ajs123/KBikeBLE/docs/RJ9coiled.jpg

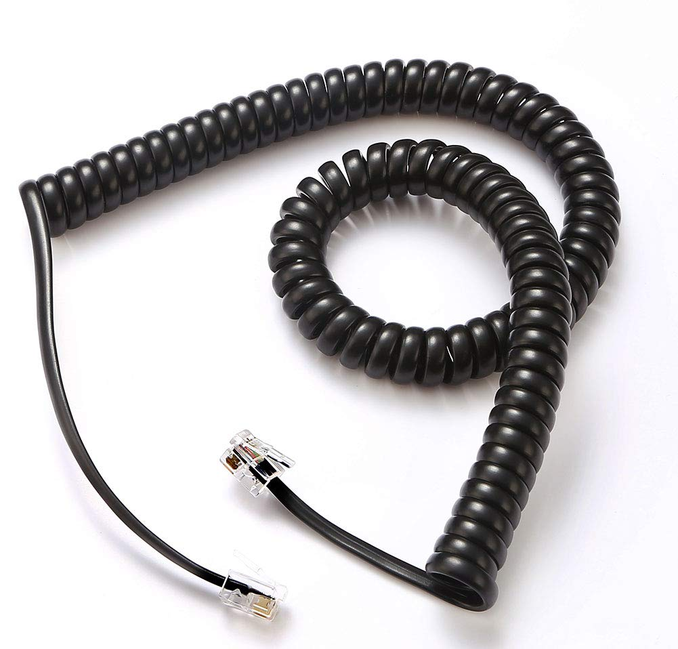
docs/RJ9coiled.jpg
