ajs123/KBikeBLE/(threads)

Thread 1 (2021-06-26):

Parts List

Longhorn17, 2021-06-26:
I'm a fellow M3 bike user and have been looking for this exact solution for my bike to be able to connect via bluetooth with fitness apps.

I'm new to coding and these kind of DIY projects in general and I thought this was a good real world project to dive into but I'm struggling a little to know which components are necessary and compatible for this project.

I was wondering if you could post a list of the exact Arduino board, display, and other parts for this project that you are using?

Sorry if this isn't the correct forum to ask this, I'm new to Github as well.

I think what you have done is pretty awesome and appreciate you sharing it.

nealjane, 2021-06-26:
Hi @Longhorn17 ,

depending where you are In The world- but an Easyer solution if you’re in Europe is the ‘Dpcycling’ m3 adapter- it’s ~£100 imported from Spain to Uk. (Have had one for 1.5years and makes your m3 work like M3i with Bluetooth)

www.siliconegrips.es

Longhorn17, 2021-06-26:
I've come across that before but unfortunately I live in the US.

I'll look into just upgrading the computer. Thanks for the suggestion!

nealjane, 2021-06-26:
https://m.facebook.com/groups/k2piconverter/permalink/983401195809979/?ref=group_browse

ajs123, 2021-06-28:
I just added a parts list.  I hope that helps!

ajs123, 2021-06-29:
I added a parts list to the archive. There are only four parts:

   - Adafruit nRF52840 Feather Express
   - Generic I2C interface 128x64 OLED display (link to the one I used in
   the parts list)
   - An RJ9 cable to plug into the connector on the bike (cut off the other
   end to connect to the Feather) as shown in the comments in the code)
   - Optionally, a battery so that you don't need to keep USB power in place
   - Some kind of case. Right now, I'm using a small cardboard box with a
   frame cut in the top, a piece of an old CD case as a window, and foam to
   keep the components from rattling around!

 I hope that helps!

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

Longhorn17, 2021-08-02:
Following up to say thanks! I have been able to get all of the parts to work on their own but am struggling to cut and strip the RJ9 cable to attach to the board. I don't know if the cables I bought are just too cheap but each time I try to strip the insulation off the smaller wires, I end up pulling all of the wiring out too.

Do you have any recommended tools or advice on the best way to connect the RJ9 cable to the board?

ajs123, 2021-08-02:
It can be hard because those cables are made to be terminated with “insulation displacement connectors” in which the wires are forced into narrow slots that cut through the insulation. A conventional wire stripper worked for me, and with care I was able to twist the conductors with a more robust lead wire, quickly solder, and cover with heat shrink tubing.

You could go with [something like this…](https://www.amazon.com/Aexit-Accessories-Telephone-Connectors-Connector/dp/B07LFHBCBC)

ajs123, 2021-08-04:
@Longhorn17 - In case it helps... I've started on a HOWTO. The beginning of it is in branch 0.18-working.

Longhorn17, 2021-08-04:
@ajs123 I started to read through the HOWTO and looks very helpful. I'm still working on connecting the RJ9 cable to the feather but hopefully am able to knock that out sometime this week. Thanks!

ajs123, 2021-08-05:
That's great. I'll be adding a bit more as I'm able.

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

ajs123, 2021-08-07:
@Longhorn17 there are now some additional cable ideas in the HOWTO.

jaredaggie, 2021-11-15:
Does anyone know if this will work with a bike made in 2009? Mine is serial number 090805-10828! Thanks for the awesome work!

jaredaggie, 2021-11-15:
> @ajs123 I started to read through the HOWTO and looks very helpful. I'm still working on connecting the RJ9 cable to the feather but hopefully am able to knock that out sometime this week. Thanks!

We're you able to get this to work on your bike? Thanks!

ajs123, 2021-11-15:
@jaredaggie Yes - It should work exactly the same. If you’re interested in
different ways to connect to the bike, see Build.md for an example using
connectors that mate with the cable in the bike.

Also please note that with v1.1 of the software the default pin assignments
on the feather have changed to make wiring a little bit more
straightforward. I see that I’ve not updated the HOWTO to match. See the
chart at the end of step 7 of Build.md. Of course you can still change
bike_interface.h to match how you chose to wire it, as long as
RESISTANCE_PIN is an analog input. I've added an update of the HOWTO to the
TODO list.

Please don’t hesitate to ask if you get stuck.

On Nov 15, 2021, 4:25 PM -0500, jaredaggie ***@***.***>,
wrote:

@ajs123 <https://github.com/ajs123> I started to read through the HOWTO and
looks very helpful. I'm still working on connecting the RJ9 cable to the
feather but hopefully am able to knock that out sometime this week. Thanks!

We're you able to get this to work on your bike? Thanks!

—
You are receiving this because you were mentioned.
Reply to this email directly, view it on GitHub
<https://github.com/ajs123/KBikeBLE/issues/1#issuecomment-969336033>, or
unsubscribe
<https://github.com/notifications/unsubscribe-auth/ABC4G2L4I47IOJ5WPC457DLUMF3E7ANCNFSM47LQKLGQ>
.
Triage notifications on the go with GitHub Mobile for iOS
<https://apps.apple.com/app/apple-store/id1477376905?ct=notification-email&mt=8&pt=524675>
or Android
<https://play.google.com/store/apps/details?id=com.github.android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>.

Thread 6 (2022-03-02):

Bluetooth Function only

chanyork, 2022-03-02:
Hello,

I love your work, unfortunately seems a bit complicated for me.

1. Is it possible to create a version for us that only add the bluetooth function to the Keiser M3, while keeping the original display please!!?
2. Does the heart beat sensor work here?

Cheers,
York

ajs123, 2022-03-08:
Hi,

The original M3 computer measures the magnet position (resistance) in a different way which precludes having both connected at the same time.

If you search online, you might be able to find an add-on box for the M3 that does just add bluetooth. The last time I checked (a couple of years ago), it was available only in Europe.

Hope that helps!

nealjane, 2022-03-08:
This guy sells them in Uk and ships worldwide - but then it only makes it into a standrd M3i (needing converter for apps like zwift) -
https://lhproducts.company.site/

chanyork, 2022-03-09:
Hello,

Thank you for your email.

Yes, I just notice that it actually prevented me to connect both at the
same time.
Any adding of diode or resistor you think can help to achieve that?

Cheers,
York Chan

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

chanyork, 2022-03-09:
Hello,

I found out just disconnect the black color line to the original computer
than you can have both computer running.  and measuring the resistance.

Cheers,
York Chan
Mobile/Whatsapp  +852 98662380
***@***.*** ***@***.***>
http://www.petpalace.com.hk

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

ajs123, 2022-03-09:
That’s interesting. It confirms my suspicion that the Keiser computer is measuring the resistance intermittently.

If you disconnect the black wire from the Keiser computer, you are using 3.3V from the feather as power to the sensor. This is likely to affect the calibration on the Keiser computer.

chanyork, 2022-03-09:
That is what I thought too.  But it did not.  Both Keiser and Kbikeble are
pretty in sync.  Hence it give me thinks that the Keiser is measuring %
changes in voltage drop.

By the way.
Can we add this in please!!!
1. ANT+ heart rate reading and send out via bluetooth as well
2. Screen to have Active Time Counter
3. Distance or Odometer I read that Keiser use 200 rap as 0.1 or 1 I can't
remember.

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

ajs123, 2022-03-11:
Keiser and KBikeBLE agreeing when connected this way might be a matter of good luck!

Regarding the other possible features...

1. ANT+  - It does appear that the nrf51 SoC supports ANT+ and BLE at the same time, so an interesting possibility.
2. Time counter - Should also be possible, as an option. Would need to make space on the display!
3. Distance/Odometer - It would be interesting if Keiser used something that simple. It's listed in the TODO as a future possibility. I was assuming that it would require a model, using power and cadence and maybe resistance...

nealjane, 2022-03-11:
See this related to Keiser speed and distance -
https://github.com/ptx2/gymnasticon/pull/89

ajs123, 2022-03-11:
Thanks, @nealjane!  I’m a little surprised, but if Keiser and Peloton are meant to simulate bikes on flat ground maybe it makes sense to have a basic wind resistance model.

ajs123, 2022-03-11:
@nealjane the latest commit includes a speed calculation using these references.  I divided the coefficients by 0.6 to provide Km/h instead of mph. The calculation is only done if FTMS services is enabled since that's the only place it's used right now, and it's untested!

Thanks again!

Closed 2022-03-16.

Thread 7 (2022-03-08):

Issue to connect to IPAD/Iphone

chanyork, 2022-03-08:
I am having trouble to connect to zwift on ipad.  Can connect to the power via bluetooth but when click on cadence it found nothing.

ajs123, 2022-03-08:
Hi @chanyork,

A couple of questions...

1. Do you have both power and cadence showing on the display?
2. Does the power reading show up correctly in Zwift?

chanyork, 2022-03-09:
On the display yes.
Zwift shows connected to the power but always shows 0.
Zwift unable to connect to Cadence.

when I disable the CPS measurement it seems to be easier to connect.

//setupCPS();

Cheers,
York Chan

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

ajs123, 2022-03-09:
Hi,

Can you see what happens if you disable FTMS instead of disabling CPS? FTMS doesn’t provide a cadence; it provides a crank count and time and leaves it for the app to calculate cadence. And the speed (Km/hr) provided with FTMS is not correct.

Let me know!

Alan

chanyork, 2022-03-09:
let me try that this few days.

chanyork, 2022-03-10:
Hello Alan,

Testing results as follow.
Device: Ipad Mini
Device: Iphone 13
Software: Zwift
FTMS enabled and CPS enabled - Cadence can not connect even bluetooth name not updated in Power but connected
FTMS enabled CPS disabled - OK
FTMS disabled and CPS enabled - Cadence can not connect even bluetooth name not updated in Power but connected
FTMS enabled and CPS enabled - Cadence can not connect even bluetooth name not updated in Power but connected

Software: Rouvy
FTMS enabled and CPS enabled - All Good.

I am not too sure what system Zwift is using but seems like it has issue with CPS.

ajs123, 2022-03-10:
To be sure I understand…

Everything works in Rouvy - both power and cadence coming through correctly?

When Zwift connects for power, is it still reading zero?

thanks!

chanyork, 2022-03-10:
Correct.

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

chanyork, 2022-03-10:
Yes, the below works.  I even removed the adddata part as well.

// setupFTMS();

at KBikeBLE.ino line 615,

try

//  Bluefruit.Advertising.addService(svc_ftms, svc_cps);   // Advertise the services
//  Bluefruit.Advertising.addData(0x16, FTMS_Adv_Data, 5); // Required data field for FTMS
  Bluefruit.Advertising.addService(svc_cps); // Advertise only the cps service

ajs123, 2022-03-11:
Just to be sure - Zwift works now?  If so, I'll disable FTMS at least temporarily.

chanyork, 2022-03-11:
Yeap Zwift and all other works.

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
--
Cheers,
York Chan
Mobile/Whatsapp  +852 98662380
***@***.*** ***@***.***>
http://www.petpalace.com.hk

ajs123, 2022-03-11:
Great!

I may have found the problem. The Fitness Machine Feature characteristic has Resistance level supported unset (because the app can't change the resistance like it could with a trainer). But in the Indoor Bike Data characteristic Resistance level present is set and the resistance is included among the data fields. I'd thought that it was OK to report the resistance even if the app can't change it.

As I re-read the spec, the resistance shouldn't be included in the Bike Data. I can give it a try, maybe this weekend.

ajs123, 2022-03-11:
I just committed changes to remove the resistance from the Bike Data characteristic. Not tested yet!

chanyork, 2022-03-11:
I just tried the new code.  It work for a short period and was back to the same situation.

ajs123, 2022-03-11:
Thanks. My advice in that case is to disable FTMS again. I'm not sure what
could be wrong but there's been so little testing with FTMS.

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

ajs123, 2022-03-11:
The latest commit provides options (options.h, around line 98) to separately enable CPS and FTMS services. On my test system (iPad), I have to disable FTMS to work with Zwift.

Using CPS, Zwift sees both power and cadence and it calculates speed.

chanyork, 2022-03-12:
>

yes I was pedaling occasionally to keep the Arduino on.  So at the moment I disable the FTMS.

ajs123, 2022-10-11:
So everything now works with Zwift?

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

chanyork, 2022-10-11:
Just tried the new code.  Does not seem to work on my side.  Still the same
results.

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

chanyork, 2022-10-11:
Yes with the removal on the line that was advices.

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
--
Cheers,
York
Tel: +852 98662380

ajs123, 2022-10-11:
Thanks. That's good to know. At least for now, it seems that FTMS will need
to be disabled to work with Zwift.

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

Thread 8 (2022-03-11):

FTMS support

tamccauley, 2022-03-11:
This software is awesome.  I am quite new to programming.  In order to get this software to work with the RGT Cycling app, I disabled Advertising of the ftms service.  Apparently RGT software didn't like that?  Before I disabled it, my board would never connect.  After disabling, it connects every time.   If I decide to pay for Zwift, maybe I will have to re-enable?  Not sure.

Thanks

tamccauley, 2022-03-11:
I just made the changes you committed relative to removing resistance from FTMS Bike Data.  Now, RGT Cycling software connects to the your software, no problem.  No need to comment out the FTMS advertising, not that I really use it anyway.  Thanks for the fix.

ajs123, 2022-03-11:
Great!

ajs123, 2022-03-11:
In the latest commit, I added options to separately enable/disable FTMS and CPS. I had to leave FTMS disabled (comment out //#define PROVIDE_FTMS) to work with Zwift. Please let me know if RGT stops working for you.

Thread 10 (2022-03-18):

Pinout not consistent across M3 builds

tamccauley, 2022-03-18:
I got my Keiser M3 working with this code, modified slightly for my display and changes to the I/O.  It appears my bike's I/O is different from the pinout identified by KBikeBLE.  Below is what I am using for my bike and it is working with RGT Cycling app.  Thanks so much for this development.

My Keiser M3 Serial No: 080118  (which means built 2008 - Jan 18)
Keiser M3 interface through the RJ9 4p4c jack:

      Red     - CRANK_PIN - crank switch to ground (dry switch, not Hall effect)
               To a digital input. Transient protection is recommended.
      Yellow  - RESISTANCE_TOP - 10K magnetic brake position sense pot high side
               Use a digital output so it can be turned off to save power
      Green   - RESISTANCE_PIN - magnet brake position sense pot wiper
               To an analog input channel
      Black   - GROUND - magnetic brake position sense pot low / crank switch low side

ajs123, 2022-03-18:
Thanks for noting this! The original test bike is from 2012.

Did you tap into the Keiser cable, or are you using a standard RJ9 handset cable? If a Keiser cable, are you able to see the colors from left to right in the RJ9 plug?

For now, I updated the HOWTO with a recommendation to check the colors as described at the end of the document.

In any event, it's so nice to see this working for other people!

tamccauley, 2022-03-18:
I ordered a 4p4c RJ9 connector and cable from digikey.  It has the exact same color coding as the cable on the bike.  To use the system, I disconnect the original cable from the jack by the flywheel and plug my cable in there.  Black Red Green Yellow, left to right looking at the connector with the tab facing me is the orientation.

ajs123, 2022-03-18:
Thanks.

[This picture of the pickup assembly](https://www.sportsmith.com/speed-pickup-assembly-with-circuit-board-keiser/product/46112?serial=1187) shows Black-Red-Green-Yellow as well, and following the traces on the photo of the back indicates Pot_high - Pot_wiper - Crank_sw - Common.

According to the parts listings at Sportsmith, the parts are different but unfortunately the photos are all of the same part.

I can further update the HOWTO.  Thanks again!

Thread 11 (2022-04-16):

Photos of hardware connection

SamuelMatson, 2022-04-16:
Thanks for this awesome project. It would be awesome if you could include or link to photos and instructions for the hardware connection on the M3. I don't have an M3 yet so I want to know what's involved with this before I make the purchase.

ajs123, 2022-04-16:
For now, there are some photos in build.md that might help. In that example, I used the cable that’s in the M3 including the connector that plugs into the M3 computer.

Please be aware that it seems that Keiser may have changed the pin assignments on the RJ9 connector on the bike. See https://github.com/ajs123/KBikeBLE/issues/10. If you go to sportsmith.com or anyplace that sells parts, and choose the sensor board, you’ll see the serial number at which they may have changed.   It’s not hard, though, to tell which pin is which as long as you have an ohm meter.

SamuelMatson, 2022-05-20:
Hi,

This is a late reply but just wanted to say thank you for your help.

Cheers,
Samuel

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

--
*SAMUEL MATSON* | FOUNDER/CEO @ SAGA HOLOGRAPHIC
website: samuelmatson.com
twitter: @samuelmatson <https://twitter.com/samuelmatson>
instagram: samuel.matson ***@***.***>

Closed 2023-01-24.

Thread 12 (2022-04-20):

Name of Bluetooth service

tamccauley, 2022-04-20:
In main routine, if I have the following, Zwift works fine: Bluefruit.setName("K");

However, if I put Bluefruit.setName("KbikeBLE"); in there, the cadence part seems to work fine and lists the service as KbikeBLE, however, the Power Source connection in Zwift show the service as K36.  It does connect, but immediately I get a No Signal alert on that service.  Speed shows up but Power does not.  I didn't pick up the latest release that allow FTMS to be disabled but I believe I have FTMS disabled on my own.
I guess I must have something messed up as I sense that other folks have this working without a problem.

ajs123, 2022-04-21:
Zwift seems to work fine for others with FTMS disabled, but it's not clear that it's working with FTMS.  Are you using V1.1, or a download from the main repository?  There was a post-V1.1 fix to remove reporting of resistance with FTMS, to be consistent with the fact that resistance can't be changed.

I did notice when I tested with Zwift that it abbreviated the name. I do wonder whether Zwift tries to do things that are dependent upon the name. Some stationary bikes that provide inflated power estimates have apparently been a problem.

I'm presently using Wahoo SYSTM and let my free Zwift trial period expire, so my ability to test is limited! Any systematic testing is appreciated!

Thread 13 (2022-07-09):

Connecting the M3 computer and  the Feather at once

wmarner, 2022-07-09:
Hi - Not sure if you considered this or not. Do you think it's possible to simultaneously connect both the M3 computer and the KBikeBLE? I split the cable to each device. When I do that, everything seems to work except there is no voltage on the resistance pin. I've tried several combinations of pullup and pulldown resisors, with no luck. (very, very newbie here).

Any ideas?

This software and build is really cool! Thank you for sharing it!

ajs123, 2022-07-09:
I haven’t looked very closely at how the M3 computer measures the resistance. I’m pretty sure that it either applies voltage to the potentiometer intermittently in order to sample the position while saving power, whereas KBikBLE keeps it energized continuously while the bike is in use, or the M3 uses some other approach altogether. I’d be cautious just in case one of the two devices could be able to damage the other.

Closed 2022-11-30.

Thread 14 (2023-01-04):

SEEED STUDIO XIAO NRF52840 compatible

tamccauley, 2023-01-04:
Just an FYI....
I got KBikeBLE's software to work with a SEEED STUDIO XIAO NRF52840 processor, which is quite a bit smaller and less expensive.  A few changes I had to make:
Added “static const uint8_t VBAT  = PIN_VBAT ;” to Variant.h file so I could use this in bike_interface.h.
In Bike_interface.h, instead of #define BATTERY_PIN A6, changed to #define BATTERY_PIN VBAT
In Arduino IDE, in board manager, added “Seeed nRF52 by Seeed Studio.

I used 1.0.0 of this board library as I believe newer versions don't support the BLE libraries in this project.

ajs123, 2023-01-22:
Thanks. This is good to know. I've noted it in the HOWTO.

Closed 2023-01-22.

Thread 15 (2023-01-16):

Featherwing OLED boot loop

antknight, 2023-01-16:
Hi,

Thanks for this awesome project!

I went ahead and purchased the Adafruit feather and featherwing OLED 128X64 as mentioned in [HOWTO.md](https://github.com/ajs123/KBikeBLE/blob/main/HOWTO.md). There is very little information available regarding using the 128X64 SH1107 OLED with U8G2 and I am struggling.

I have altered the U8G2 constructor from:
`U8G2_SH1106_128X64_NONAME_F_HW_I2C display(U8G2_R1, /* reset=*/U8X8_PIN_NONE);`
to:
`U8G2_SH1107_64X128_F_HW_I2C display(U8G2_R0, U8X8_PIN_NONE);`

Without the display plugged in, it works as expected BLE etc. When I plug the display in, as soon as the display shows "KBikeBLE" followed by the version, the feather reboots? in a loop: [Boot with USB](https://gfycat.com/orderlyhonoreddragon)

I am not really sure where to start debugging. I tested the display using the code on [this page](https://learn.adafruit.com/adafruit-128x64-oled-featherwing/arduino-code) and it works fine so no issues with the hardware.

Any help much appreciated.

UPDATE: I was just packing up for the night when I unplugged the USB cable so it was just on battery, now it almost works as expected: [Boot on battery](https://gfycat.com/impracticalvaluablelaughingthrush)
- Interesting that it boot loops when connected to USB
- Also interesting that there are those faint horizontal lines

ajs123, 2023-01-16:
Hi @antknight ,

Display anomalies can come from using the wrong constructor. But the constructor  you're using looks right to me. In another project, with that same featherwing display mounted in "landscape" rotation, the correct constructor is

`U8G2_SH1107_64X128_F_HW_I2C display(U8G2_R1, U8X8_PIN_NONE);`

so the _R0 ought to be right for you. And the wrong _Rx should just yield incorrect rotation of the display.

Behaving differently on battery suggests a hardware problem. Some thoughts:

1. Just in case it's something with the featherwing, can you try one or more of the U8G2 library examples? Hello_world in the Full Buffer group, then the Graphics Test, may be helpful.
2. More likely... after displaying "KBikeBLE" and starting bluetooth services, the startup code sets the crank switch pin to be an input then applies +3.3V to the resistance sense potentiometer (RESISTANCE_TOP).  Is it possible that that pin is shorted to ground (or connected to ground via something substantially less resistance than the bike's 10K ohm pot?

Let me know what you discover!

antknight, 2023-01-17:
I have done a bit more testing by separating the Feather and Featherwing OLED and placing them on breadboard with only VCC, GND, SDA and SCL connected (I don't have the bike sensors connected at this stage)

- The display works perfectly with the Adafruit example code.
- The U8G2 Hello_world Full buffer example doesn't work. Hello World flashes briefly on the screen then nothing else happens and it doesn't appear to be in a boot loop.

So it seems like this is a compatibility issue between the Featherwing OLED and U8G2.

I should probably raise an issue over on u8g2. I have ordered a separate 1.3" OLED as used in your example.

antknight, 2023-01-18:
In that case, I will order another Feather + Feather OLED in case there is some oddity with the bits I have. I will let you know how it goes.

ajs123, 2023-01-18:
Just in case of some recent issue with U8G2, you could first try reverting to version 2.32.15 or earlier of that library. I've found that library to be very reliable and professionally maintained but there's always a chance...

Other possible things to check before buying stuff...

- Solder joints at 3.3V and ground. The Adafruit and U8G2 libraries might set up the display chip a bit differently, so conceivably they could have different tolerances for power issues.
- Re the "boot loop" - on the Featherwing while disconnected from the Feather, check that there is no conductivity (or at least very high resistance) between RESISTANCE_TOP (see bike_interface.h) and 3.3V or ground. This pin somehow getting bridged to ground would definitely cause the boot loop.

antknight, 2023-01-19:
OK so, new displays arrived.

- The 1.3" OLED works perfectly
- The new feather + new featherwing OLED works perfectly
- The new feather + original featherwing OLED same old problem

I had a probe around with a DVM trying to find differences between the two sets of components with no success.

At this stage as I now have a working solution I think we can put it down to a hardware issue and close this ticket. Thanks for your help with this and thanks for creating such a useful project!

Closed 2023-01-19.

Thread 16 (2023-01-29):

Stuck on log screen when FTMS enabled

ajk1982, 2023-01-29:
I would like to try BitGym which I believe requires FTMS. When I enable FTMS by uncommenting #define PROVIDE_FTMS in options.h, it freezes on the log screen during startup.
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

ajs123, 2023-01-29:
Hmmm... First question: Does bluetooth start (does the blue LED begin
flashing?)

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

antknight, 2023-01-29:
No, no connection via bluetooth possible.

ajs123, 2023-01-29:
I'm not in a good position to try to replicate on this end. Would you be
able to try release v1.1 instead of main?

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

antknight, 2023-01-29:
I can confirm v1.1 works and is detected by BitGym!

ajs123, 2023-01-30:
Thanks. I added a note in the README about this being an issue in the main branch and added the fix to the TODO.

Closed 2024-01-07.

Thread 17 (2023-02-05):

Calibration tool 3D model

ajk1982, 2023-02-05:
I modelled a calibration tool for those with 3D printers. Dimensions taken from a genuine Keiser tool. Model available here:

[thangs.com](https://thangs.com/designer/MacGyver1982/3d-model/Keiser%20M3%20calibration%20tool-686222) or [printables.com](https://www.printables.com/model/387199)

ajs123, 2023-02-26:
Thanks! I added a link to this issue in the HOWTO (calibration section).

Closed 2023-02-26.

Thread 18 (2023-02-05):

Setting #define GEAR_DISPLAY false, uses GEAR label on startup

ajk1982, 2023-02-05:
If setting #define GEAR_DISPLAY false in options.h, on startup the label GEAR rather than RES % is used. Toggles correctly when moving resistance lever to the top.

ajs123, 2023-02-05:
Please try the KBikeBLE.ino as edited a few minutes ago. The fix is at line 160.  UNTESTED but should do it. Thanks for catching and reporting this.

ajk1982, 2023-02-07:
Works perfectly, thanks!

Closed 2023-02-07.

Thread 19 (2023-11-16):

My grain of sand. 3D print

serbasan, 2023-11-16:
I am very grateful for the work on this project. I have assembled everything and it is going very well. Better than the original screen.
I have designed a quick box to house all the electronics and have mentioned this project.
I don't know if I'm breaking any rules. If so, let me know.
And if a larger screen with more information is added in the future, I would design another box.
Thank you so much.
Link to box:
[Box 3D](https://www.thingiverse.com/thing:6318006/files)

ajs123, 2023-11-16:
Thanks! I've added a link to the README.

Closed 2023-12-16.

Thread 20 (2023-12-16):

Transient suppression on Crank Pin

tamccauley, 2023-12-16:
I have failed a couple Crank Pin inputs on my processors. I do not have any suppression, despite your recommendation.  I looked at the signal with a scope and it looks very clean, no voltage spikes.  Did you have problems with this input before you added surge suppression?  My project has run for hours before actually failing the input previously.  Today, it failed after only 5 minutes so trying to find a solution that I can be confident with.  Wondering if your suggestion for suppression was based on experience on this project or experience with reed switches in general or just good practice.

Thanks again for the awesome project.  I actually have this running on a Seeed XIAO NRF52840 as it is much smaller and cheaper than the Adafruit Feather you used.

ajs123, 2023-12-16:
I never tested without any protection for the input, as I assumed it would be a problem with a reed switch at the end of a longish cable. The small series resistor (which relies upon there being some capacitance at the input) was the only thing I tried.

There will always be a transient when the switch opens, the energy being dependent upon Vdd, the pull-up on the input, and the inductance of the cable. It might be hard to see depending upon the speed of your scope.

It’s cool that it works with another, economical, processor board. What Arduino libraries are you using? There are some calls to the RTOS and I don’t know how specific they are to the Adafruit implementation.

tamccauley, 2023-12-16:
I pretty much used your code. I had to make the below mods.  Thanks for the feedback.

Added “static const uint8_t VBAT  = PIN_VBAT ;” to Variant.h file so I could use this in bike_interface.h.
In Bike_interface.h, instead of #define BATTERY_PIN A6, changed to #define BATTERY_PIN VBAT

Closed 2024-01-07.

Thread 21 (2023-12-19):

The perfect couple KBikeBLE & SmartSpin2k

serbasan, 2023-12-19:
Hello. I just wanted to comment that after mounting this fantastic screen and enjoying such a good Bluetooth connection and watt measurement, I wanted to do something to use a motor map to change gears without using the lever. Searching I found another great project that did just what I wanted and also had ERG and SIM mode for Zwift.
It is a project for other types of bicycles but I have adapted it for the "Keiser M3".
I'm still testing and calibrating but I'm already enjoying it and I think it may be of interest to anyone who already has this screen. I have modified the files and have the STL for the "Keizer M3" that I will share shortly when I finish making all the changes.

I haven't been able to train yet due to illness but this week I will start and check how it works with long training sessions.

My impressions have been very good so far and I am very impressed with the result.

Any help here we can comment.

In this [link](https://github.com/doudar/SmartSpin2k/discussions/494) I comment on the adaptation.

All the best.

Thread 23 (2024-10-23):

Disable change shifting/resistance by moving the resistance lever to the top

serbasan, 2024-10-23:
Hello.

I want only gears 1-24 to be displayed. How can I disable the change to the 1-100% mode?

It happens during training that I’ve moved the lever all the way up, and the display changes. It’s a bit annoying because I’m very used to the 1-24 gears.

I would appreciate knowing which part of the code I should modify.

Thank you very much.

ajs123, 2024-10-23:
Hi,

In KBikeBLE.ino, you can comment out lines 811 and 812 as follows (actual line numbers will be different if you're using another release):

//    gear_display = !gear_display;
//    rg_label = rg_labels[(int)!gear_display];

serbasan, 2024-10-24:
Thank you very much, I have changed it now. I am really enjoying your project with SmartSpin2k. They work together wonderfully with my training and racing. Are you still using your Keiser M3? I hope so. Best regards.

ajs123, 2024-10-24:
I am. I’m a percentage person. My wife is a gear person. Thus the feature.
This should really be a configuration option!

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

Closed 2024-10-24.

Thread 24 (2024-12-12):

What can this connect to?

travisvanneste, 2024-12-12:
This will be my first arduino project, so forgive the newbie question..

I'm looking to connect this to Wahoo fitness app (or anything else really) - just wondering if this is going to send both the power data and cadence out via bluetooth...  The end goal of course is to work with something like zwift, but at first just to be able to log data.

Wahoo appears to look for bluetooth sensors, just not sure if it will recognize this as a sensor?

ajs123, 2024-12-12:
KBikeBLE appears to apps as a standard bluetooth power meter, providing power and cadence. Much of my personal use has been with Wahoo X and it worked just fine.

travisvanneste, 2024-12-12:
That’s great!  Looking forward to bringing Bluetooth connectivity to two
old M3 bikes that I own.

You did great work putting this together!

 I may 3d print an enclosure to make the new computer attach to the bike….
Or I may try and use the old display as it looks like someone else who
commented on this did…. Really all I’m interested in is the Bluetooth
functionality.

Thanks again for your great work!

Travis W. Van Neste
Van Neste Surveying
3845 40th Ave South
Minneapolis, MN 55406

952-686-3055

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

travisvanneste, 2024-12-30:
So I got this working with Wahoo - reading power and cadence - any way for
it to get 'speed' to wahoo?  I'm sure the Keiser computer gets its speed
from cadence / power?

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

Thread 25 (2025-01-22):

Shouldn't his work without the display?

travisvanneste, 2025-01-22:
I build two of these - 1 without the display because I was really only interested in using the bluetooth functionality.  I build a small enclosure with a short phone cord and rj9 connector on one end and a phone jack on the other end so that the original computer still works (connected all wires internally except the black, per recommendation of another user).  Seems to work pretty good.

The one without the display does not work though  - it connects to bluetooth but shows zero watts and zero rpms.  Also the keiser computer will not work when hooked up to it.  I cannot find anything different except not having the display wired.

Any suggestions?

ajs123, 2025-01-22:
I'm not certain what it will do without a display. The display is initialized before bluetooth, so your experience suggests that at least none of the functions called in display_setup() hang in the absence of a display.

One thing you could try, short of temporarily adding a display: Start but don't connect to bluetooth, and wait for the blue LED to go dark. Then turn the crank and see if it wakes up. That would demonstrate that crank sensing is happening.

robbybara, 2025-08-01:
I was thinking about this as well. I would like to keep the current screen and just intercept the data and provide a pass-through so that it just uses the screen that it already has. I was thinking this must be possible.

ajs123, 2025-08-02:
Here’s the challenge:

Thread 26 (2025-04-20):

Question about simultaneous display use

magpern, 2025-04-20:
I'm doing a similar project for older BodyBike spinn bikes and I got the question if I can support Keiser M3.
My question is, would it be possible to get the data from the Keiser M3 by "man in the middle" approach?
Goal is to still have the old display on the bike, but just get the data from the bike and transform it into BLE (and/or ANT+)

ajs123, 2025-04-20:
It’s possible but would require some study of how Keiser measures the resistance magnet position and design of corresponding electronics or software approach. Keiser doesn’t maintain a fixed voltage at the potentiometer. Most likely (to save battery), they apply the voltage briefly each time the computer takes a measurement. So it may involve, for example, a peak hold on the wiper voltage.

magpern, 2025-04-20:
Thanks for replying. I saw there is(was) some device you could buy as a "man in the middle" thing that converted the bike to bluetooth, but quite expensive.
In my head a Y-connector from sensor, one leg of the Y feeding the display, then the other leg of the Y to an nRF52840 (and some resistors in between according to chatGPT). Don't know if it could be that simple, then one could monitor the peak of the wiper voltage. The reed sensor should be fine.
I'll guess I'll just have to try.

Closed 2025-04-20.

Thread 27 (2025-05-28):

Keiser 4 pin connector type

eideben, 2025-05-28:
Would someone be able to provide a link to the 4-pin 2 mm connector used on the Keiser M3? The link in the Build.MD file appears to be missing. Thanks :)

ajs123, 2025-05-30:
I don't know what happened to the links for those parts! I'll look for them. I should at least still have the DigiKey order...

Closed 2025-05-30.

Thread 28 (2025-07-11):

Compatibility List / Check

Sc0ttmeup, 2025-07-11:
Is it possible to get a known compatibility list along with any caveats for M3 models, or a way to check if models are compatible with KBikeBLE?

I'm pretty sure the manufacture date on mine is in November 2021, any idea if KBikeBLE will work?

- Model: 005502BBC
- Serial No: 211116-xxxxx

nealjane, 2025-07-12:
M3bike from late ~2015 onwards just needs a computer replacement (m3i computer/or M-connect) to be upgraded to full m3i with bluetooth. (Serial states manufacture date eg YYMMDD)

ajs123, 2025-07-12:
KBikeBLE was intended for the M3. As far as I can tell (I looked at replacement parts [here](https://sportsmith.com/parts-by-brand/keiser/bikes/m3i/5501xxx/?_bc_fsnf=1&Item+Type=Speed+Sensors)), the crank speed and resistance pickup board on the M3i is the same, so it ought to work. That's consistent with @nealjane's reply noting that the M3i computer will work with a late model M3.

Sc0ttmeup, 2025-07-18:
I confirmed that the M3i M Series / with M Connect Computer is compatible with the part listed.

@nealjane if I understand you correctly, a M3i manufactured in November 2021 will be compatible with KBikeBLE?

[sportsmith keiser m3 Speed Pickup with Circuit Board, Keiser, 550817 _ 550817, 550904, 550869.pdf](https://github.com/user-attachments/files/21316625/sportsmith.keiser.m3.Speed.Pickup.with.Circuit.Board.Keiser.550817._.550817.550904.550869.pdf)

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
