ajs123/KBikeBLE/(commit log)

2021-05-30 Implemented table lookup for gear and power. Separated some bits into includes.
2021-05-30 Filter re-instated on cadence calc until occasional reporting of half-cadence is fixed
    [KBikeBLE.ino]
2021-05-31 Remove cadence filter, force battery check on display wakeup
2021-06-01 Code to use FreeRTOS ticks instead of millis()
2021-06-02 Playing with power saving approaches
2021-06-02 More power saving ideas in comments
2021-06-18 Power management changes
2021-07-11 Switched from Arduino loop() to FreeRTOS timer
2021-07-24 Fixed error in the cBLEUart class
    [KBikeBLE.ino, globals.h, options.h, serial_commands.h]
2021-07-30 Tweaks to ADC config
2021-08-04 Set default options for the current Adafruit core
2021-08-04 Fixed missing type in analogCalibrateOffset()
    [KBikeBLE.ino]
2021-08-04 Updated README to include current capabilities
2021-08-07 Option to operate without battery
2021-08-09 Brake indicator
2021-09-20 Update HOWTO with info on Keiser cable connectors
2021-09-27 Update HOWTO with cable info
2021-09-30 Case build documentation
2021-10-03 Finished Build.md, fix to Vdd monitoring.
    [KBikeBLE.ino, bike_interface.h, globals.h, options.h]
2021-10-03 Fixed error in Vdd cal
    [KBikeBLE.ino]
2021-10-05 Switch to Vdd ref, new default cal
2021-10-05 Update instructions on calibration change
2022-03-11 Removed resistance from FTMS Bike Data
2022-03-12 Correction to speed estimate
    [BLE_services.h, KBikeBLE.ino]
2022-05-03 Reminder to check cable colors in Build.md
2023-02-05 Fix starting GEAR/RES label
    [KBikeBLE.ino]
2023-02-05 Fix GEAR/RES% label at startup
    [KBikeBLE.ino]
2025-05-30 Update Build.md with link to the inline connector
